joshithagopal3-cmd/aura-lift/aura-lift/docs/dashboard-trips.png

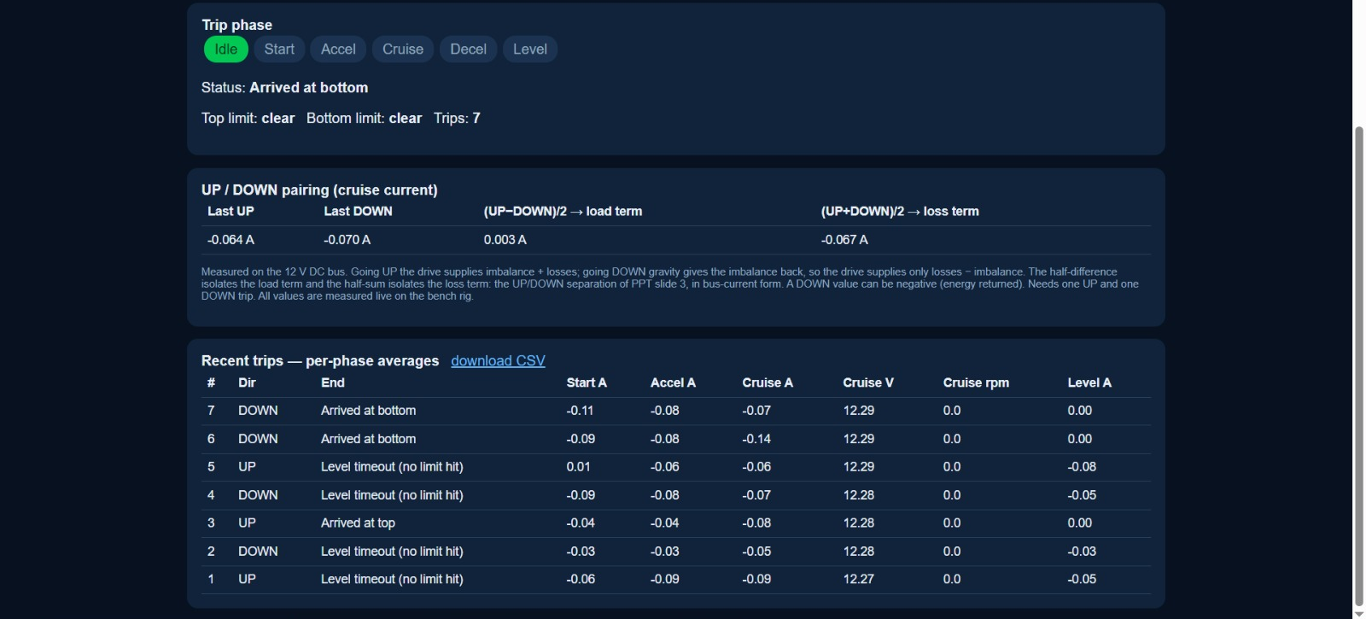
aura-lift/docs/dashboard-trips.png
