joshithagopal3-cmd/aura-lift/aura-lift/docs/simulation-dc-link-capacitor.png

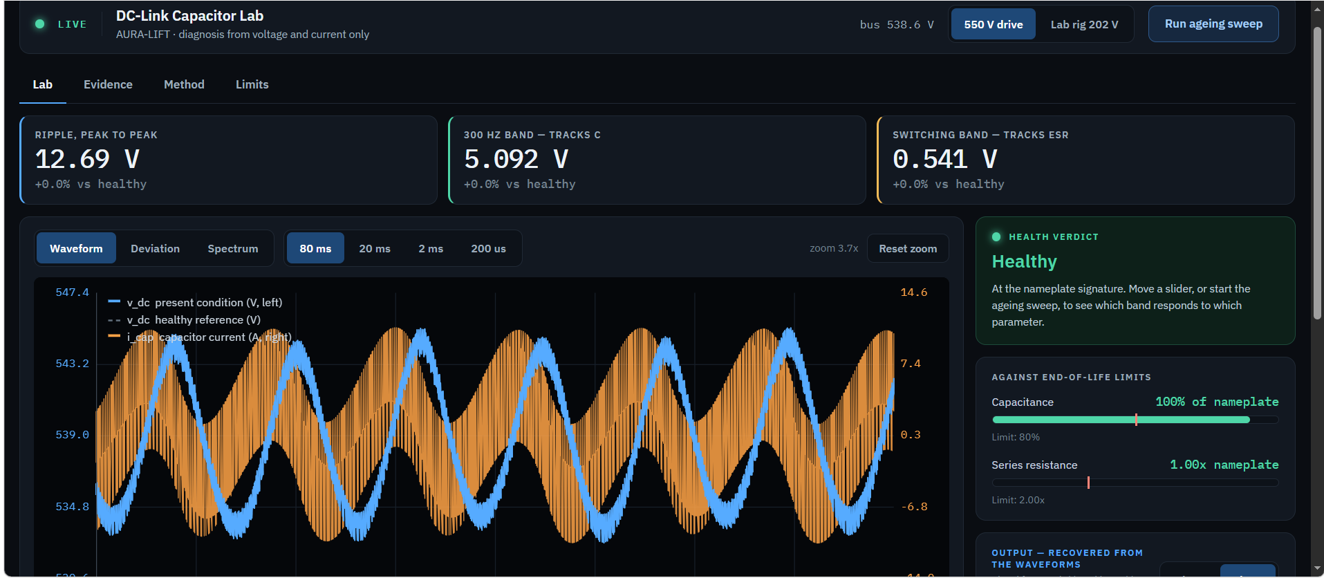
aura-lift/docs/simulation-dc-link-capacitor.png
