joshithagopal3-cmd/aura-lift/aura-lift/docs/simulation-suite.png

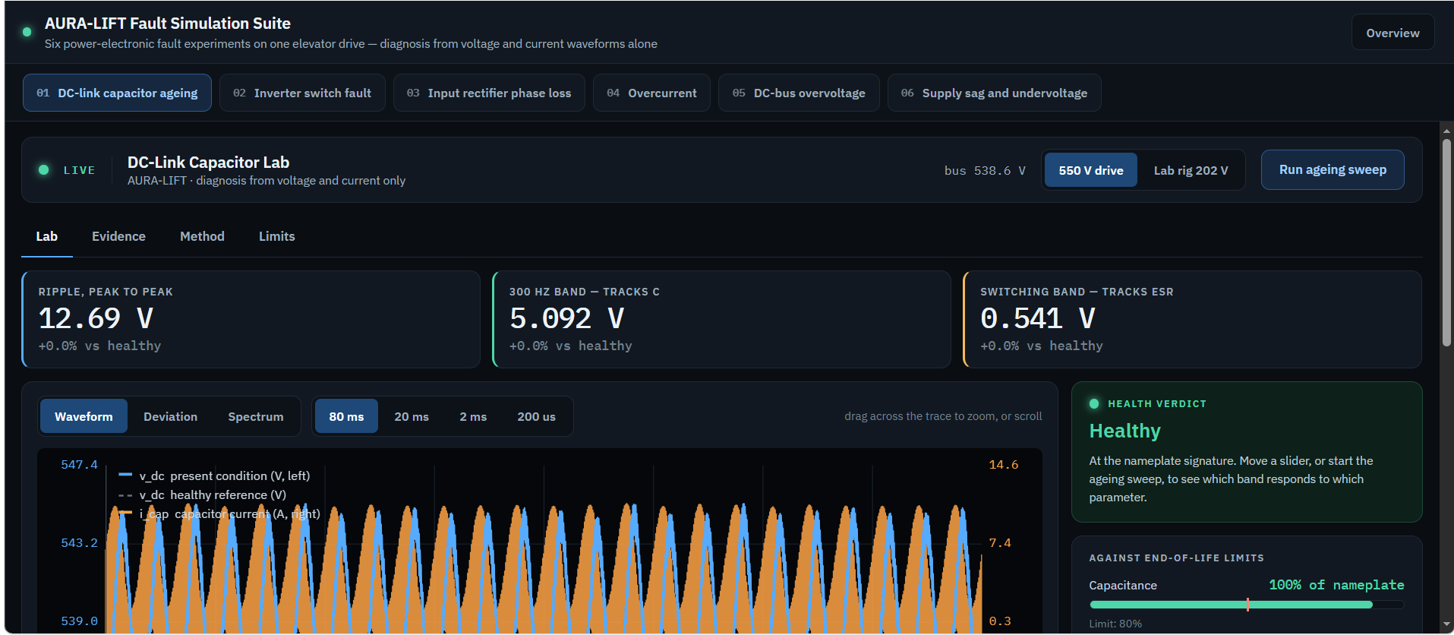
aura-lift/docs/simulation-suite.png
