joshithagopal3-cmd/aura-lift/aura-lift/docs/bench-rig-guide.docx

# AURA-LIFT bench rig — what it does

Oct 17, 2026 · @Sathya Krishnasamy

## What this rig is

The AURA-LIFT bench rig is a table-top model elevator that measures its own supply current and voltage on every trip, and shows them live on a web dashboard. It is the hardware half of Team Immortal's entry for Kone Elevate problem statement PS-06, "trip-synchronous, stage-differential electrical diagnostics for elevator drives".

The software half (simulation, CUSUM, component attribution) runs separately on a PC. This rig exists to prove, on real measured signals, the two ideas the method rests on:

1. Trip-stage segmentation — every trip is split into fixed stages, and each measurement is attached to the stage it was taken in.
2. UP/DOWN load cancellation — a run up and a run down at the same load are compared, so the load term drops out and the loss term survives.

The PPT calls this an "optional isolated bench rig" (slide 2) and a "bench proxy" (slide 7). Nothing here touches a real elevator or a real drive.

## The parts and what each one does

Part | Job in the rig
200 mm cabin, counterweight 0.5–1 kg, 40–60 mm top pulley | The mechanical elevator. The counterweight is what makes an UP run and a DOWN run differ in torque sign.
12 V 100 RPM DC gear motor | Drives the pulley. Stands in for the traction machine.
BTS7960 (HW-039) motor driver | Switches the motor forward and reverse, and sets speed by PWM. Stands in for the inverter.
ACS712-20A current sensor | Hall-effect sensor in the 12 V supply line. Measures bus current, 100 mV per amp.
0–25 V voltage sensor module | Resistor divider on the 12 V bus, measured ratio 5.05:1. Measures bus voltage.
LM2596 buck converter | Makes 5.0 V from 12 V. Its only job is to power the ACS712.
2 micro limit switches | Top and bottom end stops, wired normally-closed so a broken wire also stops the motor.
ESP32 dev board | Runs the trip profile, reads both sensors, stores the trips and serves the dashboard over WiFi.
12 V 2 A adapter | The only power source for the motor side.
Laptop USB cable | Powers the ESP32 and carries the Serial Monitor.

The LM393 slot sensor is wired nowhere, because there is no slotted disc for the shaft. Speed therefore reads "n/a" everywhere.

## How it is wired

The build splits in two. One 12 V adapter feeds everything by chaining screw terminal to screw terminal, with at most two wires under any one screw. The 12 V never reaches the breadboard, and the ESP32 never sees more than 3.3 V.

### 12 V side (screw terminals)

# | From | To

1 | Adapter + | ACS712 screw T1
2 | ACS712 screw T2 | BTS7960 B+
3 | Adapter − | BTS7960 B−
4 | BTS7960 B+ (2nd wire) | LM2596 IN+
5 | BTS7960 B− (2nd wire) | LM2596 IN−
6 | LM2596 IN+ (2nd wire) | Voltage sensor VCC screw
7 | LM2596 IN− (2nd wire) | Voltage sensor GND screw
8 | LM2596 OUT+ (set to 5.0 V) | ACS712 VCC pin
9 | LM2596 OUT− | Breadboard GND row

The motor goes on M+ and M−. Wire 9 is what ties the 12 V ground to the ESP32 ground; without it no reading works.

### Breadboard side (3.3 V, GND and signals)

Part | Pin | Goes to
ESP32 | 3V3 / GND | 3.3 V row / GND row
BTS7960 | VCC / GND | 3.3 V row / GND row
BTS7960 | RPWM / LPWM | G25 / G26
BTS7960 | R_EN / L_EN | G32 / G33
ACS712 | OUT | 10 kΩ to divider column, second 10 kΩ to GND row
Divider mid-point | — | G34
ACS712 | GND | GND row
Voltage sensor | S / − | G35 / GND row
Top limit switch | NC / COM | G18 / GND row
Bottom limit switch | NC / COM | G19 / GND row

The BTS7960 logic runs from 3.3 V, not 5 V, so the driver can never push 5 V back into an ESP32 pin. The 10 kΩ pair halves the ACS712 output, which keeps G34 inside the ESP32's accurate ADC range. R_IS, L_IS, the voltage sensor's + pin and both NO contacts stay empty.

## What happens during a trip

One press of UP or DOWN runs a fixed profile, the same every time. That repeatability is what makes two trips comparable.

Stage | PWM duty (0–255) | Time | What it stands for
Start | 60 | 300 ms | Break-away from standstill
Accel | ramps 60 → 150 | 1500 ms | Peak motoring draw
Cruise | 150 | 3000 ms | Constant speed; the stage the UP/DOWN pairing uses
Decel | ramps 150 → 70 | 1000 ms | Slowing down
Level | 70 | up to 5000 ms | Slow approach to the floor, ends at the limit switch
Idle | 0 | — | Driver disabled, waiting

During every stage the ESP32 samples bus voltage and bus current (32 readings averaged each time) and adds them to that stage's record. At the end of the trip it stores one row per stage holding the sample count, average voltage, average current, average speed and peak current. Twenty trips are kept in memory.

A new UP or DOWN is ignored while a trip is running; the firmware prints "busy — stop first". A real lift finishes its trip before reversing, and slamming a spinning motor into reverse is what destroys drivers.

## The dashboard

The ESP32 serves the page itself. It first tries to join the WiFi named in the code; if that network is not found it starts its own hotspot AURA-LIFT (password auralift123) and serves the page at http://192.168.4.1. The hotspot is the safer choice for a demo, because it depends on nobody's router.

The page refreshes about twice a second and shows:

- Four live tiles — bus current, bus voltage, motor speed ("n/a", no encoder) and PWM duty.
- Four buttons — UP, DOWN, STOP and Re-zero current.
- Trip phase — Idle, Start, Accel, Cruise, Decel, Level, with the active one lit, plus a status line, both limit-switch states and the trip count.
- UP/DOWN pairing — last UP cruise current, last DOWN cruise current, and the two derived terms.
- Recent trips — one row per trip with per-stage averages, and a CSV download of every stored trip.

Route | What it returns
/ | The dashboard page
/api | All live values as JSON
/trips | Stored trips as JSON
/csv | Every stored trip, one row per stage
/cmd?c=up|down|stop|zero | The four commands

The same four commands work from the Serial Monitor as single letters: u, d, s, c, and ? for status. While a trip runs, the serial port also streams a DATA, line with time, trip number, stage, duty, voltage and current, which can be captured for plotting.

## The UP/DOWN pairing

This is the part of the PPT the rig reproduces most directly, and it is the reason the counterweight is there.

Going up, the motor has to supply the weight imbalance plus all the losses. Going down, gravity gives the imbalance back, so the motor supplies only the losses minus the imbalance. Writing the cruise-stage bus current of each run with L for the load term and F for the loss term:

I_{up} = L + F \qquad I_{down} = F - L

Adding and subtracting separates them:

L = \frac{I_{up} - I_{down}}{2} \qquad F = \frac{I_{up} + I_{down}}{2}

The dashboard prints both terms as soon as one UP trip and one DOWN trip exist. Add weight to the cabin and the load term should move while the loss term stays put. Add friction, for example by pressing lightly on the belt, and the loss term should move while the load term stays put.

That is slide 3's "their sum holds the load term, their difference holds the loss term" in bus-current form. Because this is a DC bus and not a three-phase drive, the two terms are swapped compared with the slide's torque-current version: the subtraction isolates load here, the sum isolates loss.

## How to run it

The order matters, because this build has no pull-down resistors on the driver's enable pins. Plugging 12 V in only after the ESP32 has booted takes their place.

1. Plug the USB cable into the laptop. Wait about five seconds for the board to boot.
2. Plug in the 12 V adapter. After about 1.5 seconds the firmware zeroes the current sensor and the status changes from "Waiting for 12 V" to Ready.
3. Join the WiFi AURA-LIFT (password auralift123) and open http://192.168.4.1.
4. Press UP, wait for the phase to return to Idle, then press DOWN.
5. To stop, upload new code, or press RST: unplug the 12 V adapter first.

The auto-zero matters because the ACS712 is powered from the LM2596, which is powered from 12 V. With the adapter off, the sensor is dead and the current reading is meaningless. Until the zero is taken the dashboard shows "--" instead of a number. If the zero ever looks wrong, press Re-zero current with the motor stopped.

For the first runs, take the belt off the pulley so the cabin cannot move while directions and currents are being checked.

## What protects the rig

Protection | How it works
Limit switches | Wired normally-closed with the ESP32's internal pull-ups. A pressed switch and a broken wire read the same, and both stop the motor. A trip will not start into a limit that is already reached.
Over-current stop | Above 3.0 A the trip ends and the driver is disabled. The first 400 ms are blanked so normal start-up inrush is not treated as a fault.
Under-voltage check | A trip will not start below 9.0 V, so the motor is never driven from a half-dead supply.
Trip timeout | Any trip longer than 15 seconds is ended as a fault, so nothing can run unattended.
No mid-trip reversal | UP and DOWN are refused while a trip is running.
Driver disabled on stop | Every trip end drops R_EN and L_EN, so the output stage is off between trips.
3.3 V logic | The BTS7960's logic side runs from 3.3 V, so no 5 V can reach an ESP32 pin.
Power-up order | 12 V arrives only after boot, so the driver cannot twitch while the pins are still floating.

There is no fuse in the build. The 2 A adapter and the firmware limit are what stand in for one, so keep a hand near the plug during the first runs.

## What the rig does not do

Stating this plainly is what keeps the demo credible. The rig is a DC proxy, not a VFD, so several estimators in the PPT have nothing to measure here.

In the PPT | Why not on the rig
Three-phase currents, Clarke/Park, negative-sequence fraction | The motor is DC. There are no three phases.
DC-link capacitance and ESR in the regenerative window | There is no capacitor bank, and the adapter cannot absorb returned energy.
Converter loss, P_dc − P_ac | Needs AC-side measurement, which the rig does not have.
Brake pick charge | There is no brake coil.
CUSUM, expectation model, Bayesian attribution, Streamlit view | These live in the teammate's simulation, not in the ESP32.
≥ 10 kS/s sampling with galvanic isolation | The ESP32 averages 32 readings per sample. Good for stage averages, not for waveforms.
Motor speed | No slotted disc, so the encoder is not connected.

So the honest claim for the demo is: the rig measures real voltage and current, segments them by trip stage, and performs the UP/DOWN cancellation on live data. Component-level diagnosis stays in the simulation.
