joshithagopal3-cmd/aura-lift/aura-lift/hardware/wiring-12v-side.png

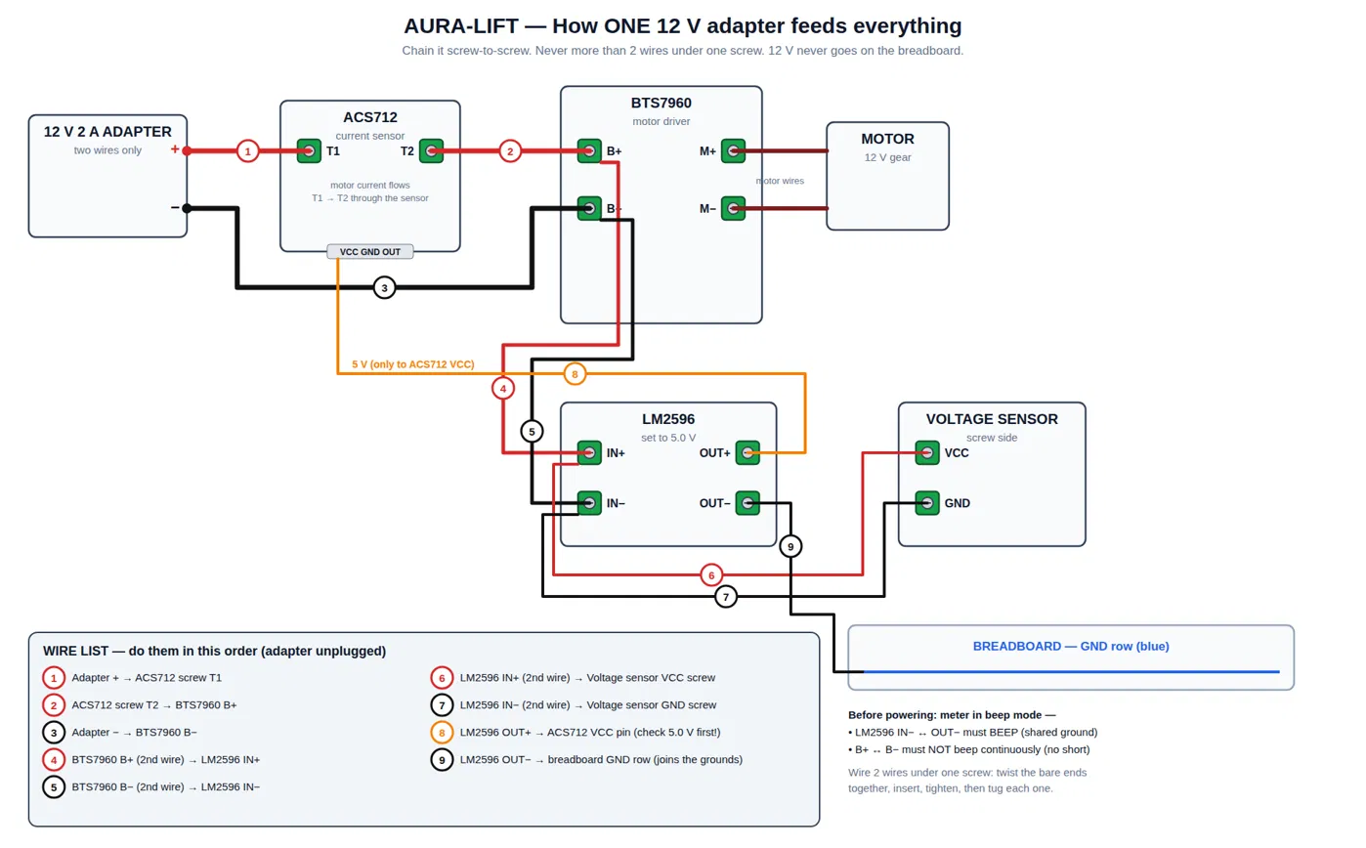
aura-lift/hardware/wiring-12v-side.png
