joshithagopal3-cmd/aura-lift/aura-lift/hardware/wiring-breadboard-side.png

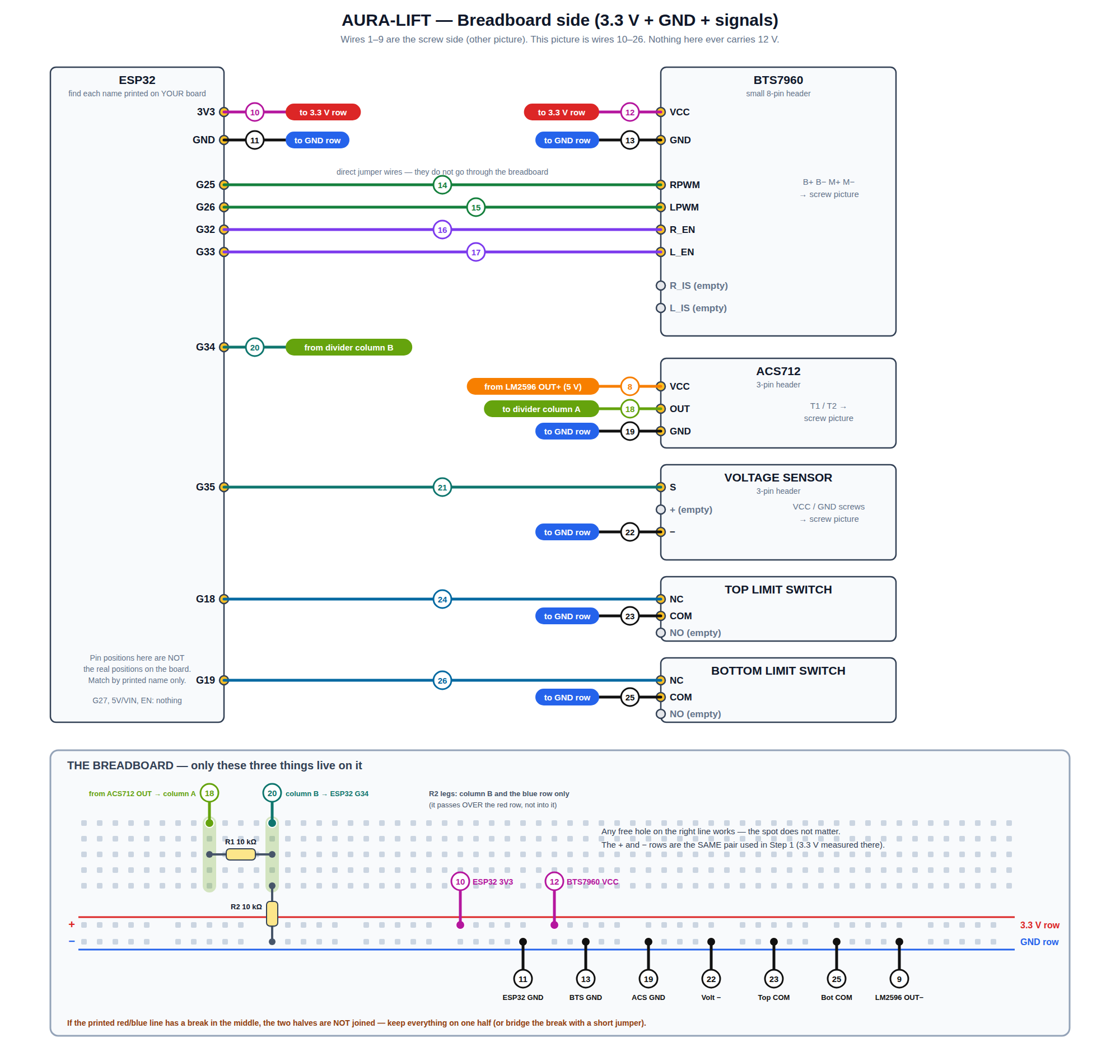
aura-lift/hardware/wiring-breadboard-side.png
