joshithagopal3-cmd/aura-lift/(commit log)

2026-10-17 Add files via upload
    Add ESP32 firmware
2026-10-17 Create firmware.ino
    Add Esp32 firmware
